Raphael-Boichot/Mitsubishi-M64282FP-dashcam/SD/README.md

# These files have to be copied at the root of SD card.

## Powershell scripts made by [HerrZatacke](https://github.com/HerrZatacke)

- **Upscaler_Camera.ps1** converts 1x BMP files from /Camera folder to 8x PNG;
- **Upscaler_Slitscan.ps1** converts 1x BMP files from /Slitscan folder to 8x PNG;
- **Upscaler_MS.ps1** converts raw datafiles files from /MS (Motion Sensor) folder to 8x PNG; 
- **Upscaler_TL.ps1** converts raw datafiles files from /TL (Time Lapse) folder to 8x PNG;

I you want to directly store Motion Sensor and Timelapse images in BMP (for example because you have no access to Powershell on your OS, set timelapserawrecordingMode to 0 in json config file (see next section). Recording in BMP format decreases a bit the available recording fps (it goes down to about 3 at most instead of 4).

## Matlab and GNU Octave conversion scripts

The projet comes with image conversion codes both compatible with Matlab if you are rich enough or [GNU Octave](https://octave.org/). Sadly, movie maker is only Matlab compatible but animated gifs are cool enough anyway. If you like Python, do not hesitate to PR codes, I would be glad to add them.

The script to make RGB animations contains all the necessary inputs to balance each color individually. The DashBoy Camera itself just does its best to expose as optimally as it can with each filter (thus collecting the maximum possible information). It's up to the user (you) to calibrate the white balance manually.

## json configuration file

**config.json** is the general configuration file for the DashBoy Camera. It has always priority on internal default configuration. Config.json is not a mandatory file but it pimps available options.

User can keep the current default values without modifying anything. Advanced user are advised to look into code what is the effect of each parameter. **Value can be changed but not the length of tables. Values MUST be entered as decimal.** Here is the signification of each variable in detail:

- **timelapserawrecordingMode:** 1 = recording to .raw file, 0 = recording to 1x bmp files with a limit of 1024 files per folder (it od course increases the folder # automatically in case of folder capacity overflow);
- **timelapseDelay:** list of actions associated with the timelapse button. Any positive value is a delay for timelapse in ms (even zero), -1 is the regular camera mode, -2 is the motion sensor mode, -3 is slit-scan infinite mode and -4 is slit-scan x128 mode. The list **must began by -2 then -1**, other values/oreder are not critical;
- **prettyborderMode:** >1 = pretty borders, 0 = image without border. Quick reboot during "NOW BOOTING... message to roll over the borders;
- **nightMode:** 1 = allows to go decrease the sensor clock to over expose image at night, 0 = constant sensor clock;
- **motiondetectionThreshold:** value for the motion detection threshold. 0 = detect everything, 1 = detect nothing. 0.025 is a good starting value, the lower, the lore sensitive to motion;
- **enforce2DEnhancement:** 1 = 2D enhancement always activated, 0 = set by registers - Valid only with dithering off;
- **cancel2DEnhancement:** 1 = 2D enhancement always deactivated, 0 = set by registers - Valid only with dithering off;
- **hdrExposures:** list of 8 exposures in HDR mode, in multiplier of the last best known exposure. It is recommended to stay within -1EV to +1EV. Taking 8 times the value 1 creates a multi-exposures shot;
- **ditherMatrix:** dithering matrix used in single register strategy, derived from a 4x4 bayer matrix. Create your own by going to [this fancy site](https://herrzatacke.github.io/dither-pattern-gen/);
- **gameboycameraMode:** 0 = single register strategy, 1 = Game Boy Camera strategy with variable registers;
- **lowvoltageThreshold:** voltage threshold for black level in non dithered Game Boy Camera strategy (0=0.0 Volts, 255 = 3.3 volts);
- **highvoltageThreshold:** voltage threshold for white level in non dithered Game Boy Camera strategy (0=0.0 Volts, 255 = 3.3 volts);
- **lowditherMatrix:** dithering matrix used in Game Boy Camera strategy - low ligth or high exposure times, derived from a 4x4 bayer matrix; 
- **highditherMatrix:** dithering matrix used in Game Boy Camera strategy - high ligth or low exposure times, derived from a 4x4 bayer matrix;
- **fixedExposure:** 0 = auto-exposure, 1 = fixed exposure, for astrophotography for example;
- **fixedDelay:** max is 65535 (about 1 second), min is 48 (about 0.768 ms);
- **fixedDivider:** clock divider, the more, the longer the exposure. For example 2 double the exposure time;
- **lookupTableRGB565:** Colorscale for display, may increase comfort and contrast, go to [this other fancy site](https://herrzatacke.github.io/gradient-values/) to generate your own (just copy paste table of values to the json);
- **exposurexWindow:** exposure box width in pixels, centered (max is 128, whole image);
- **exposureyWindow:** exposure box heigth in pixels, centered (max is 120, whole image);
- **focusPeaking:** 0 = normal mode, 1 = [focus peaking](https://en.wikipedia.org/wiki/Focus_peaking) activated;
- **focuspeakingThreshold:** threshold for focus peaking. The lower the value, the more pixels indicates good focusing (values 0..255).
- **M64283FPsensor:** 0 = normal mode, 1 = special strategy to handle the unobtainium M64283FP sensor. It is advised to deactivate gameboycameraMode when using this mode to swicth to a single register strategy.
- **slitscanDelay:** delay between slits in ms in slit-scan mode. 0 allows recording about 12 slits per seconds in full sun. 2000 gives interesting images with clouds. Be creative !
- **colorMode:** 0 = normal mode, 1 = gives help to create color animation in timelapse mode: faster autoexposure and color filter to use indicated. A PWM signal is also output on GPIO22 (see next variable). Using the servo output is not mandatory, you can pass filters by hand.
- **colorservoPositions:** triplet for RGB positions of the servo arm in degree. PWM is on GPIO22. To power the servo, use a [wire connected to any 5V line](/Docs%20and%20research/Image%20files/PCB_bare_version_2.0_servo_wiring.png) (possible) or an external power source (better).
- **jsonCorruption:** do not modify, internal check for json integrity. If this value is not reported correctly, json is considered as corrupted, copy a fresh one to SD card.

## Convert images to movie, script made by [HerrZatacke](https://github.com/HerrZatacke)

Just install ffmpeg from Powershell ran as administrator following this method: **[Method 2: Install FFmpeg via Chocolatey](https://adamtheautomator.com/install-ffmpeg/)**.
Then run the following command into you image folder (png or bmp, adapt it):
    
    ffmpeg -i %07d.png -s 1024x896 -sws_flags neighbor -r 30 -vcodec libx264 -c:v libx264 -crf 30 -pix_fmt yuv420p output.mp4
    
Or use the Matlab codes provided (GNU Octave version is not able to generate video files, only animated gifs).
