Raphael-Boichot/Mitsubishi-M64282FP-dashcam/PCB/128x160_PCB and schematic/README.md

To be edited with the Standard version of EasyEDA. These PCB versions have been validated in real.
Be carefull with the JST/ZH 9 pin socket, it must be **a vertical SMD socket** or there is a risk of polarity inversion
