Raphael-Boichot/Mitsubishi-M64282FP-dashcam/Docs and research/Image files/Project schematics.pptx

LOCK

HDR

Dither

TL/C

REBOOT

Record

SD_MISO

SD_CS

SD_MOSI

FREE

+3.3V

CAM_VOUT

CAM_GND

CAM_VCC

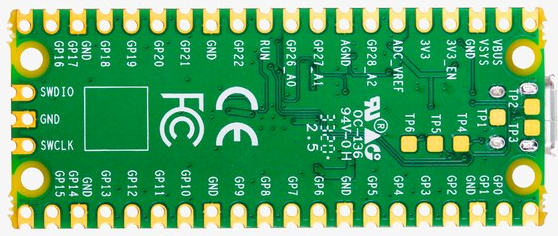
[picture p24: figure]

SD_SCK

FREE

CAM_READ

CAM_CLOCK

Access to SD card

Exposure time

CAM_RESET

CAM_SIN

CAM_START

CAM_LOAD

READ

RESET

SDA

SCK

FREE

SIN

LOAD

RESET

CLOCK

A0

CS

FREE

FREE

FREE

FREE

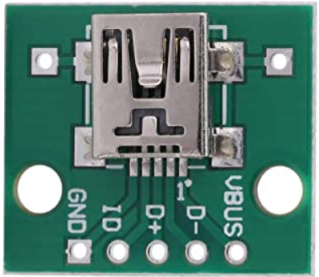
[picture p25: figure]

START

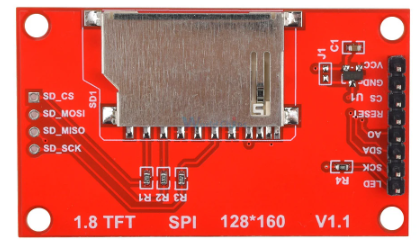
[picture p26: figure]

+5V

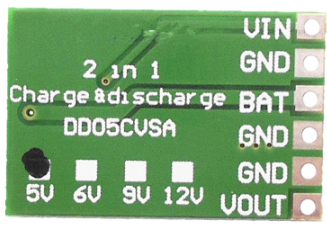
[picture p27: figure]

Display ON/OFF

Main ON/OFF

Batt+

Batt-

## Slide 2

LOCK

HDR

Dither

REBOOT

Record

SD_MISO

SD_CS

SD_MOSI

FREE

+3.3V

CAM_VOUT

CAM_GND

CAM_VCC

SD_SCK

FREE

FREE

CAM_READ

CAM_CLOCK

Access to SD card

Exposure time

CAM_RESET

CAM_SIN

CAM_START

CAM_LOAD

READ

RESET

SDA

SCK

TL/C

SIN

LOAD

RESET

CLOCK

A0

CS

FREE

FREE

FREE

FREE

START

+5V

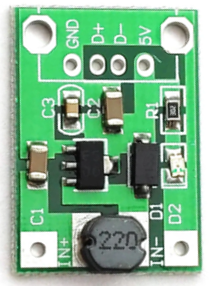
[picture p28: figure]

Display ON/OFF

Batt+

Batt-

Main

2xAA NiMH
