Raphael-Boichot/Mitsubishi-M64282FP-dashcam/Docs and research/Image files/Slit_scans.pptx

Slit-scan mode infinite

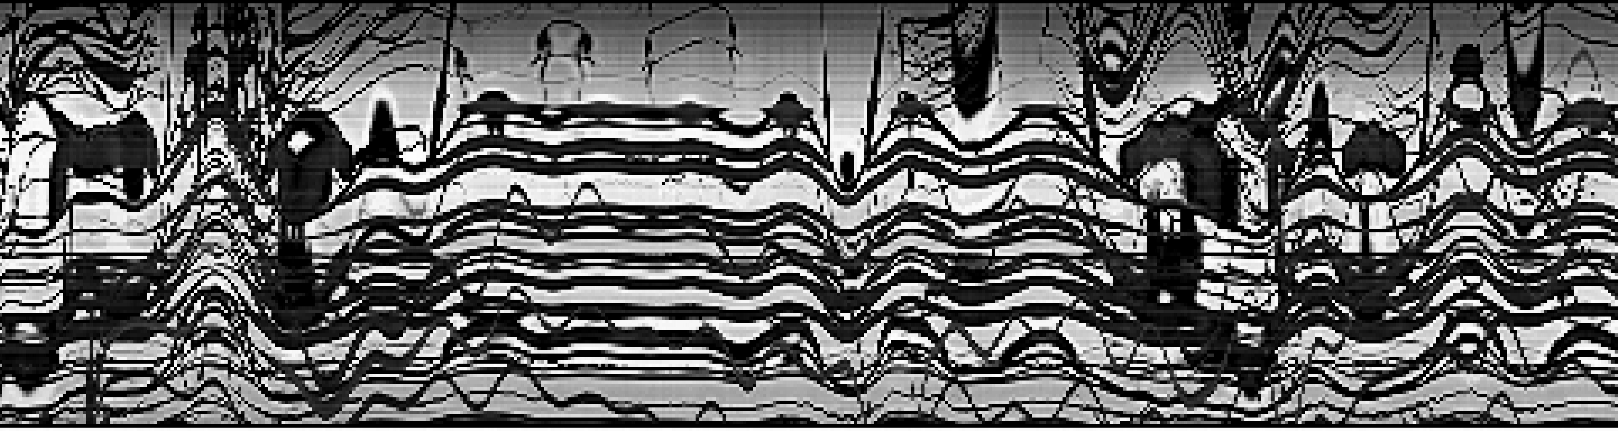
[picture p29: figure]

Slit-scan mode x128

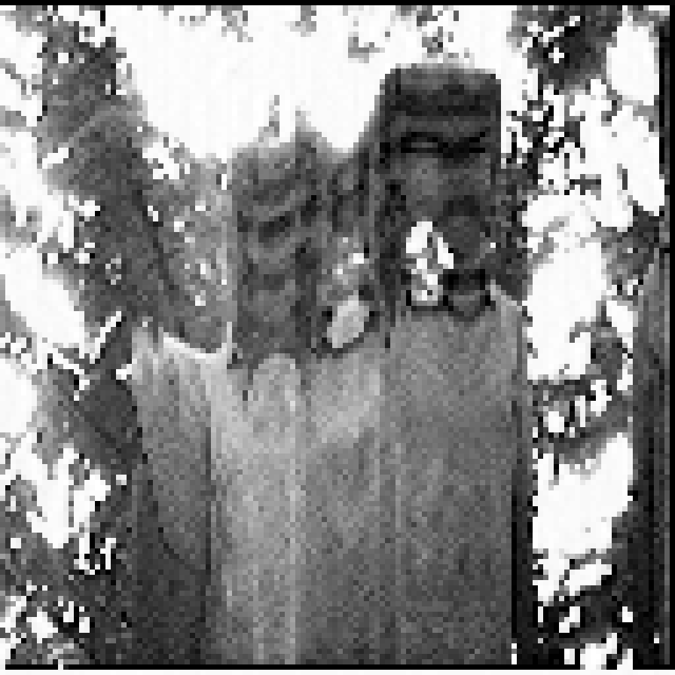
[picture p30: figure]
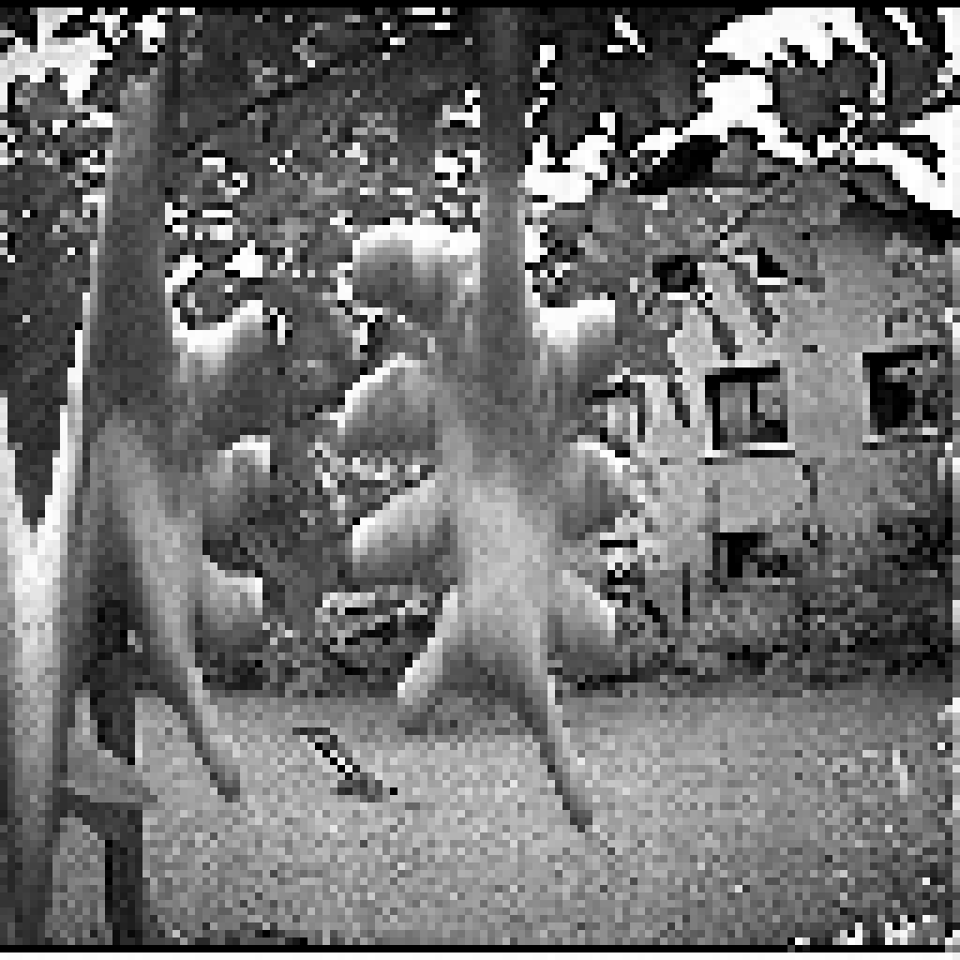
[picture p31: figure]
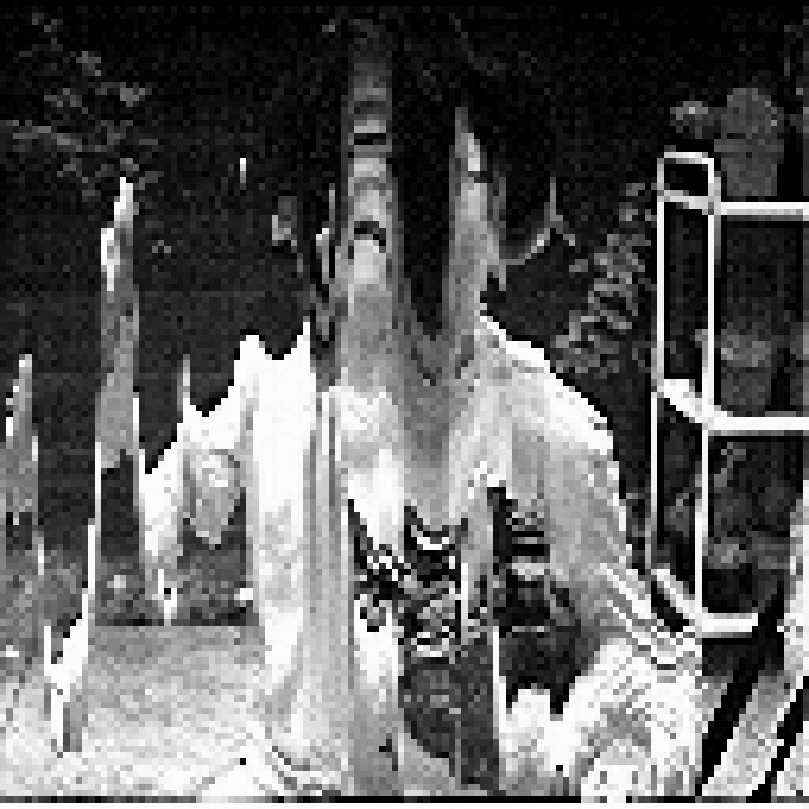
[picture p32: figure]
