Raphael-Boichot/Mitsubishi-M64282FP-dashcam/Docs and research/Bibliography/Joypad 73 Mars 1998 page031 (French).jpg

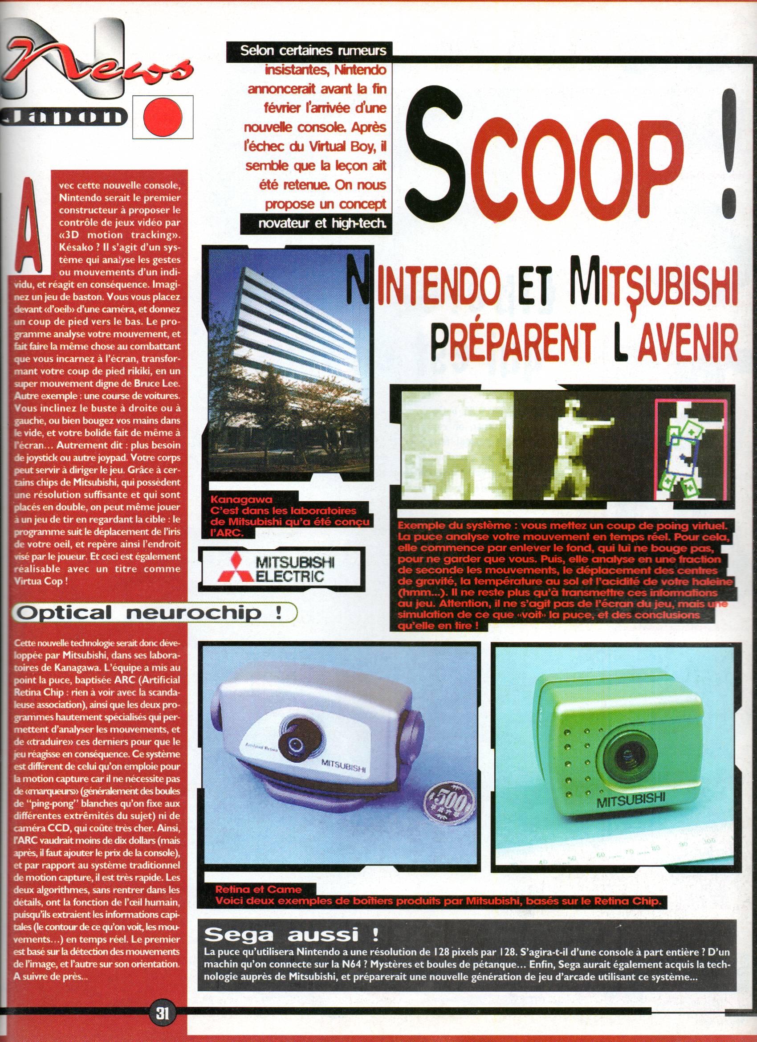
Docs and research/Bibliography/Joypad 73 Mars 1998 page031 (French).jpg
