Raphael-Boichot/Mitsubishi-M64282FP-dashcam/Docs and research/Bibliography/RGB sensor.png

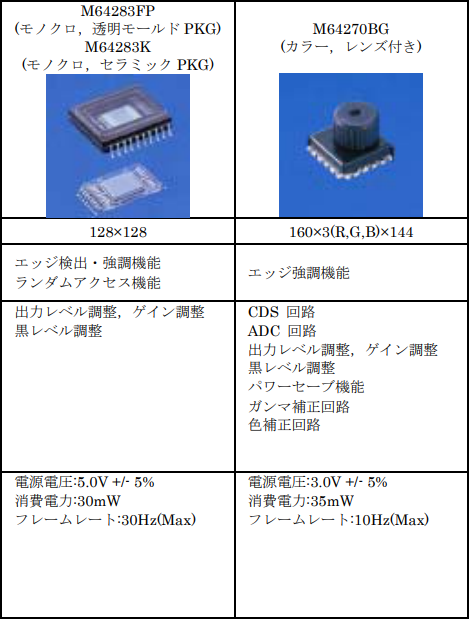
Docs and research/Bibliography/RGB sensor.png
