Raphael-Boichot/Mitsubishi-M64282FP-dashcam/Docs and research/Image files/9 pins JST connector.png

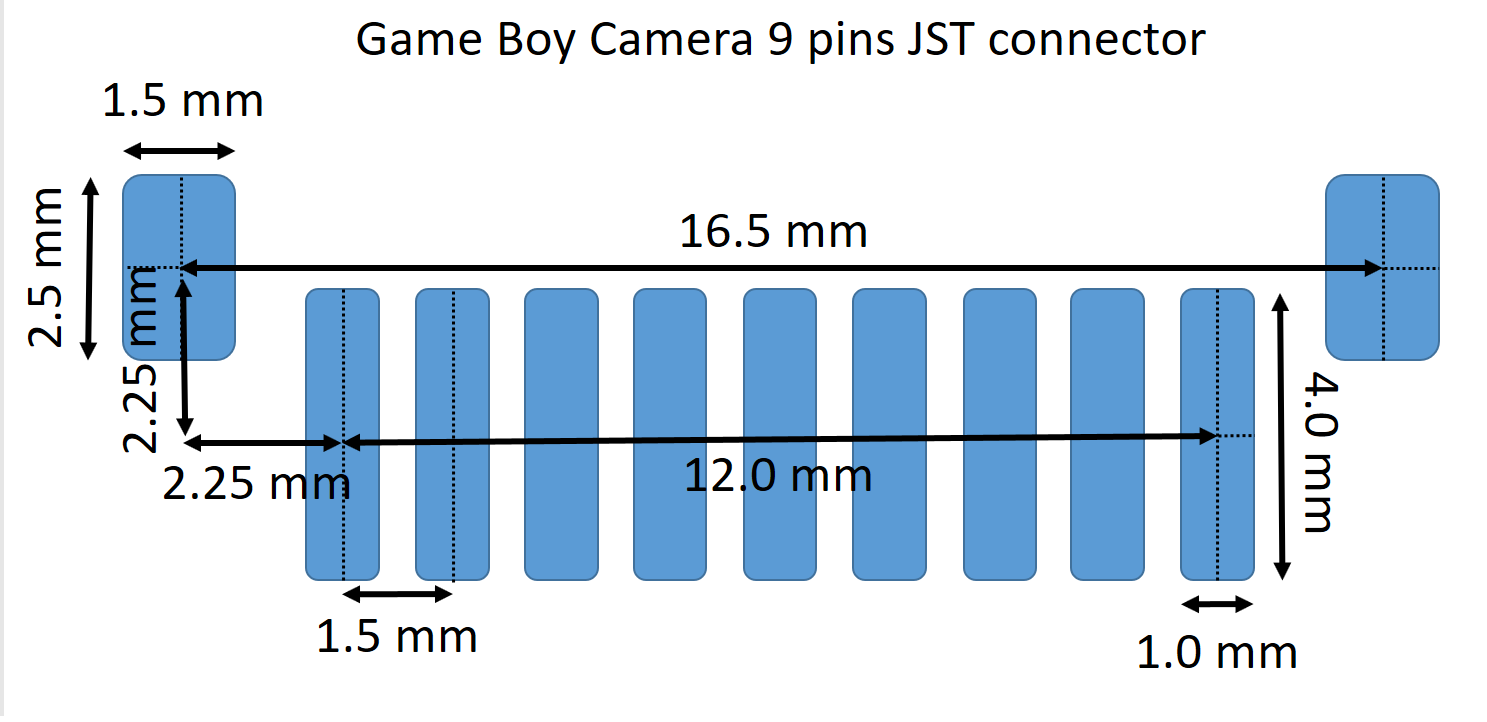
Docs and research/Image files/9 pins JST connector.png
