Raphael-Boichot/Mitsubishi-M64282FP-dashcam/Docs and research/Image files/Backside.png

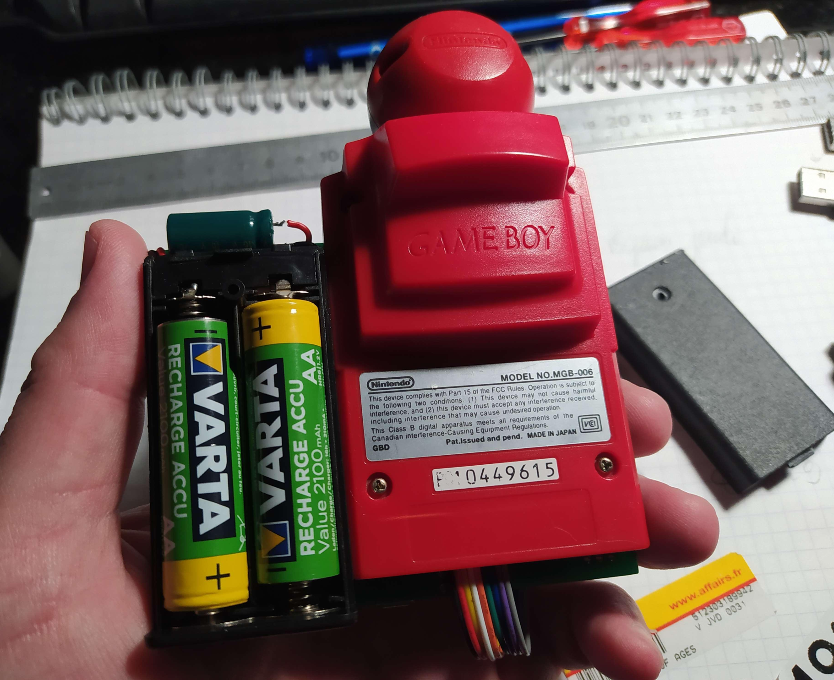
Docs and research/Image files/Backside.png
