Raphael-Boichot/Mitsubishi-M64282FP-dashcam/Docs and research/Image files/Colorwheel back.jpg

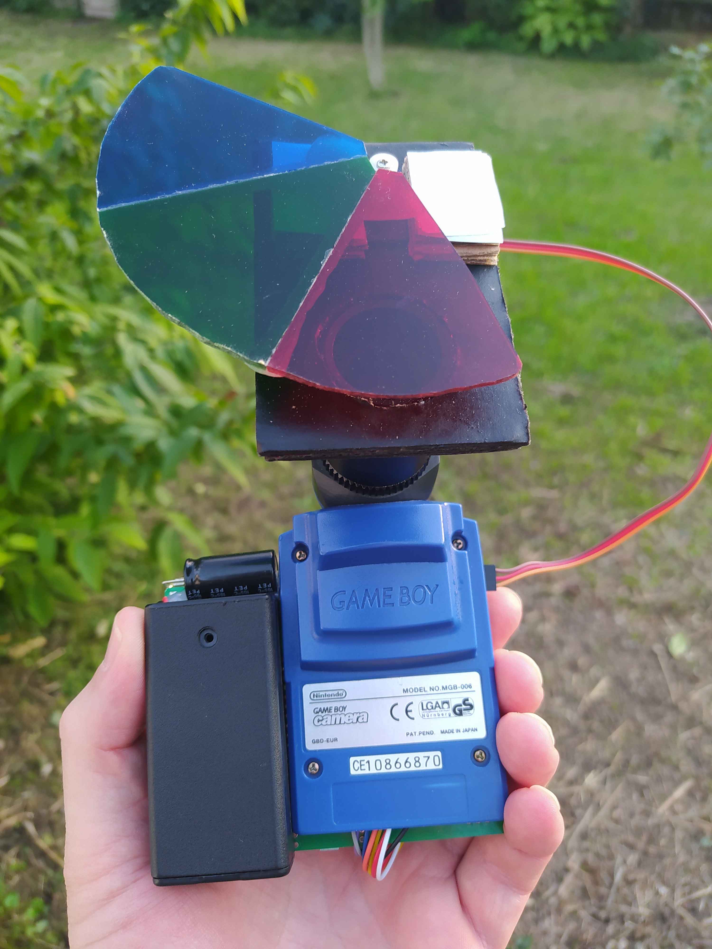
Docs and research/Image files/Colorwheel back.jpg
