Raphael-Boichot/Mitsubishi-M64282FP-dashcam/Docs and research/Image files/Colorwheel front.jpg

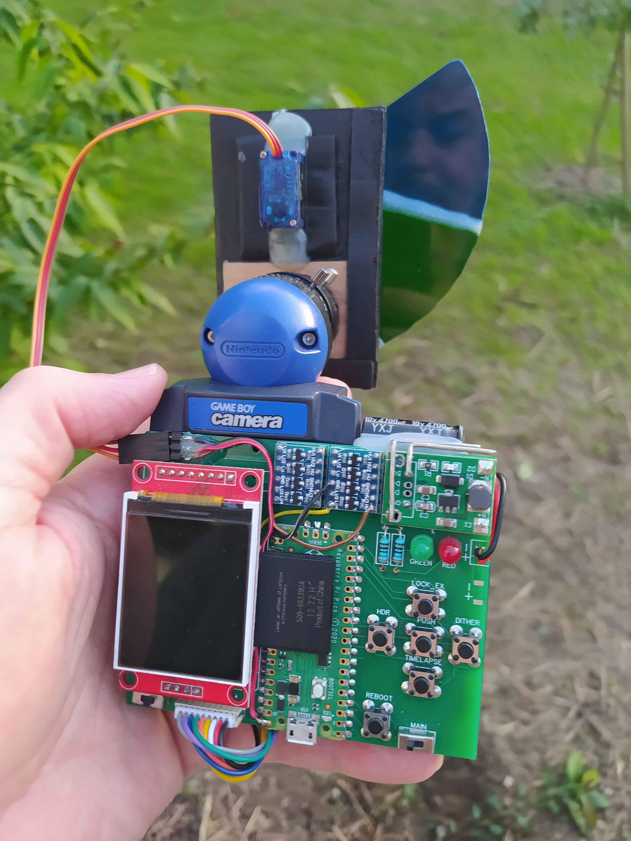
Docs and research/Image files/Colorwheel front.jpg
