Raphael-Boichot/Mitsubishi-M64282FP-dashcam/Docs and research/Image files/Comparison.png

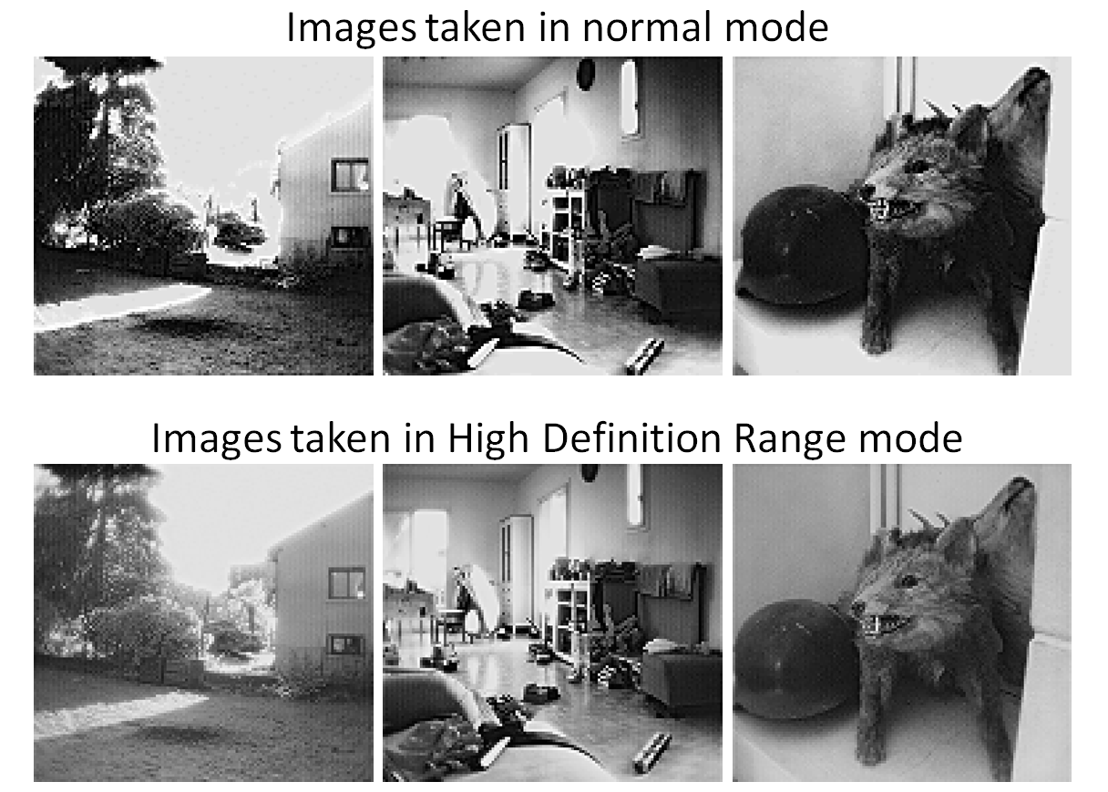
Docs and research/Image files/Comparison.png
