Raphael-Boichot/Mitsubishi-M64282FP-dashcam/Docs and research/Image files/Concept_board_February_2023.jpg

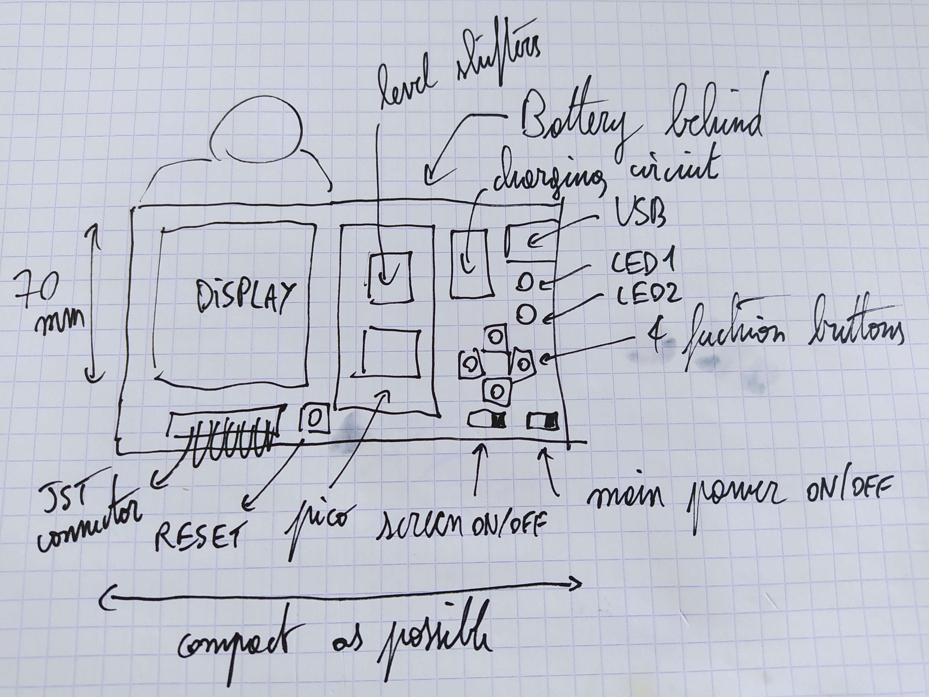
Docs and research/Image files/Concept_board_February_2023.jpg
