Raphael-Boichot/Mitsubishi-M64282FP-dashcam/Docs and research/Image files/Fatal_error.jpg

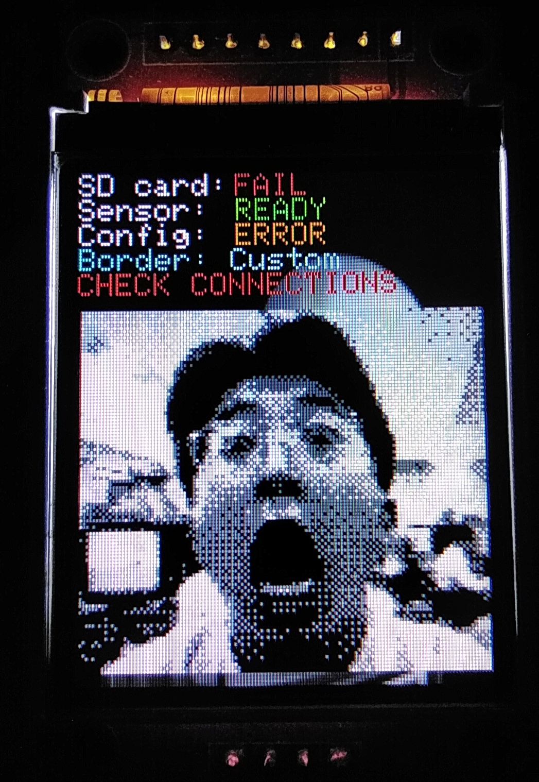
Docs and research/Image files/Fatal_error.jpg
