Raphael-Boichot/Mitsubishi-M64282FP-dashcam/Docs and research/Image files/Image of a M64282FP taken with a M64283FP.png

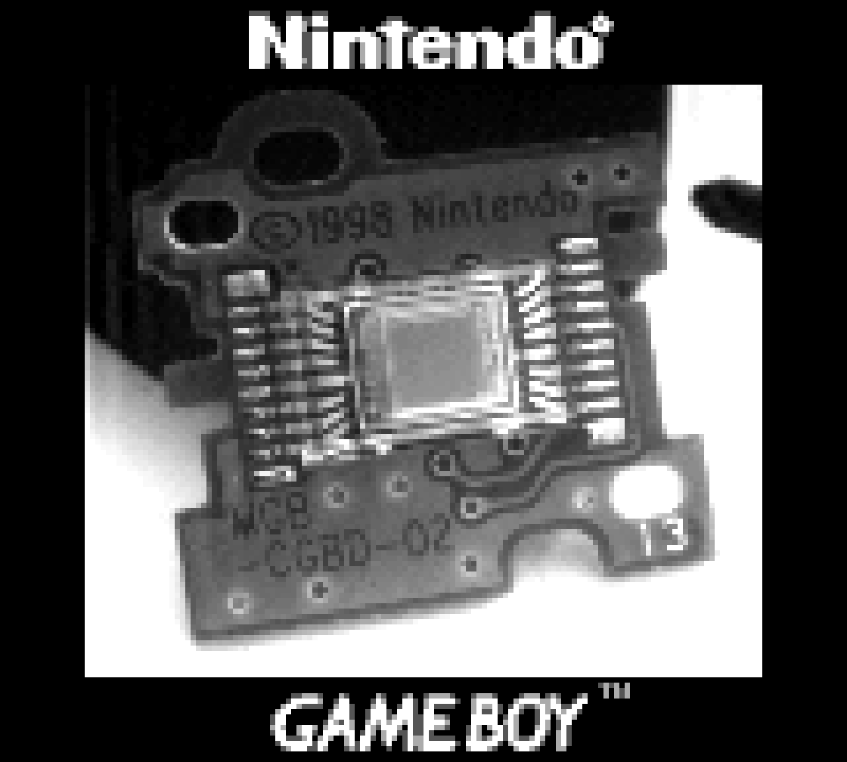
Docs and research/Image files/Image of a M64282FP taken with a M64283FP.png
