Raphael-Boichot/Mitsubishi-M64282FP-dashcam/Docs and research/Image files/PCB_bare_version_2.0.png

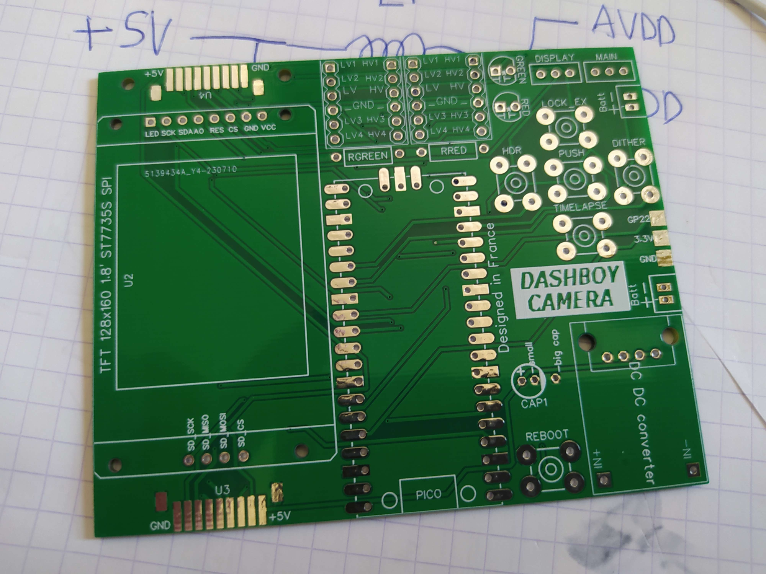
Docs and research/Image files/PCB_bare_version_2.0.png
