Raphael-Boichot/Mitsubishi-M64282FP-dashcam/Docs and research/Image files/Prototype.png

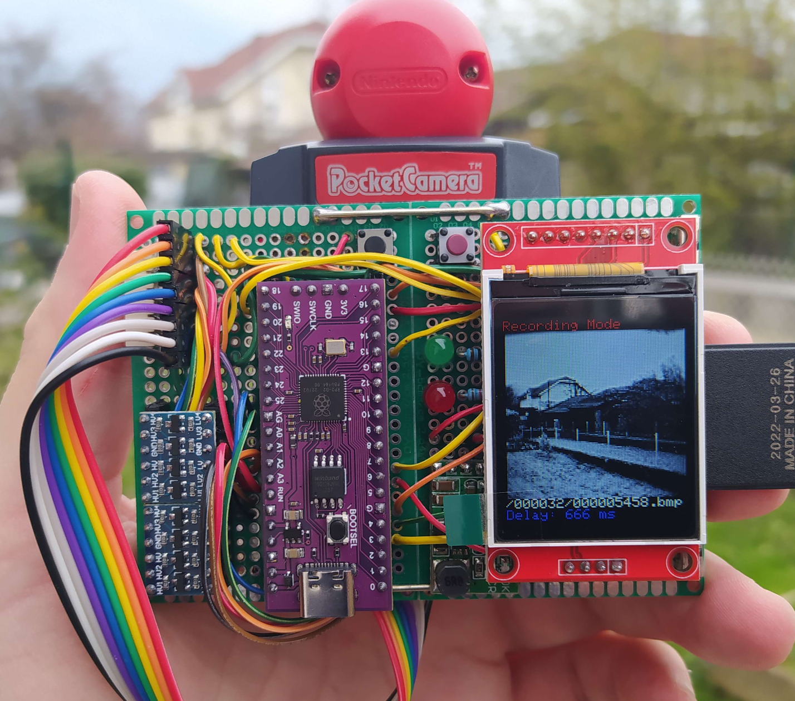
Docs and research/Image files/Prototype.png
