Raphael-Boichot/Mitsubishi-M64282FP-dashcam/Docs and research/Image files/Prototype_ESP32_2022.jpg

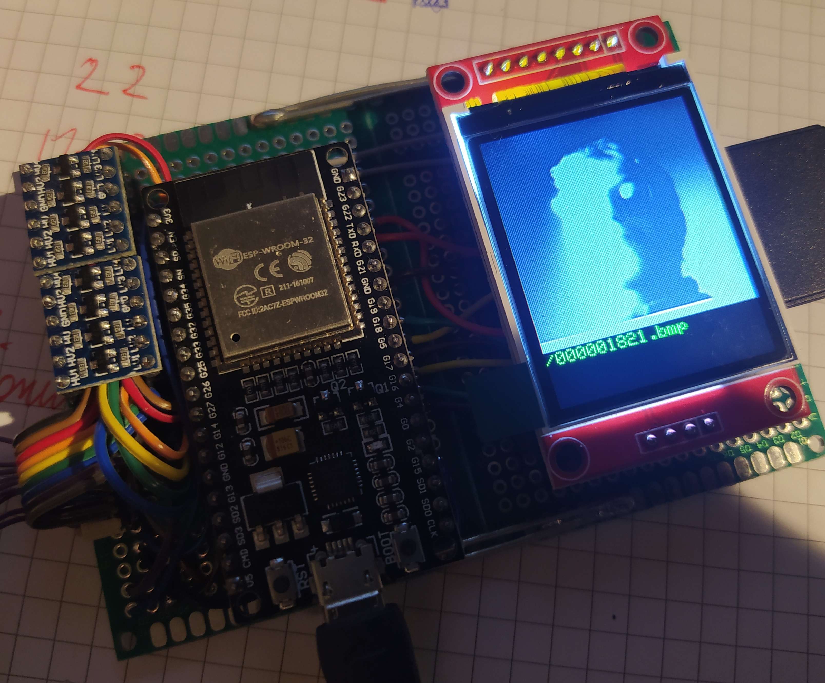
Docs and research/Image files/Prototype_ESP32_2022.jpg
