Raphael-Boichot/Mitsubishi-M64282FP-dashcam/Docs and research/Image files/RGB_example_3.gif

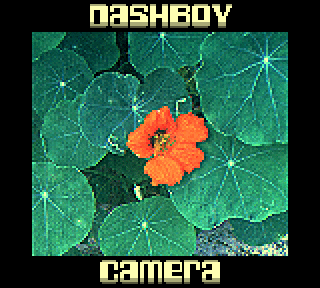
Docs and research/Image files/RGB_example_3.gif
