Raphael-Boichot/Mitsubishi-M64282FP-dashcam/Docs and research/Image files/RGB_example_5.gif

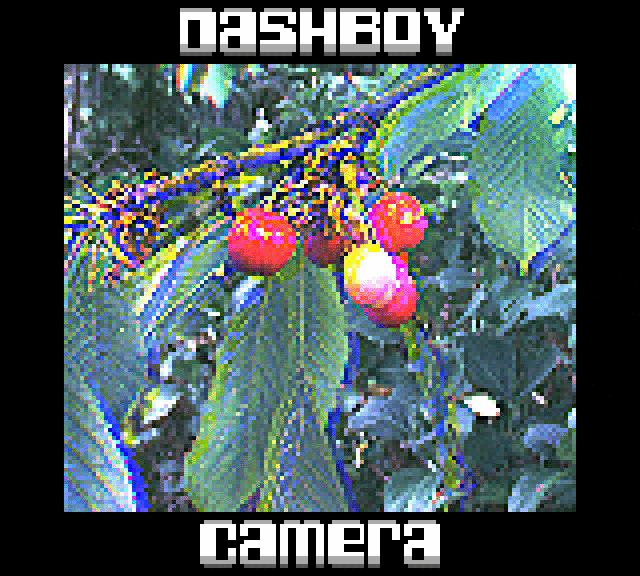
Docs and research/Image files/RGB_example_5.gif
