Raphael-Boichot/Mitsubishi-M64282FP-dashcam/Docs and research/Image files/Sensor_comparison_2.JPG

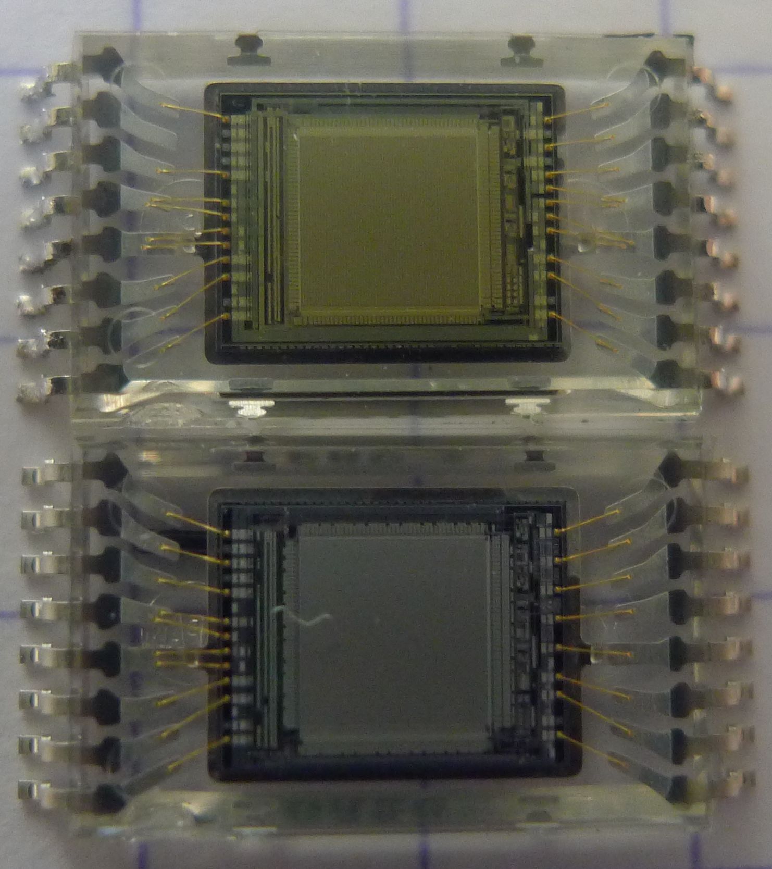
Docs and research/Image files/Sensor_comparison_2.JPG
