Raphael-Boichot/Mitsubishi-M64282FP-dashcam/Docs and research/Image files/Sensor_pinout.png

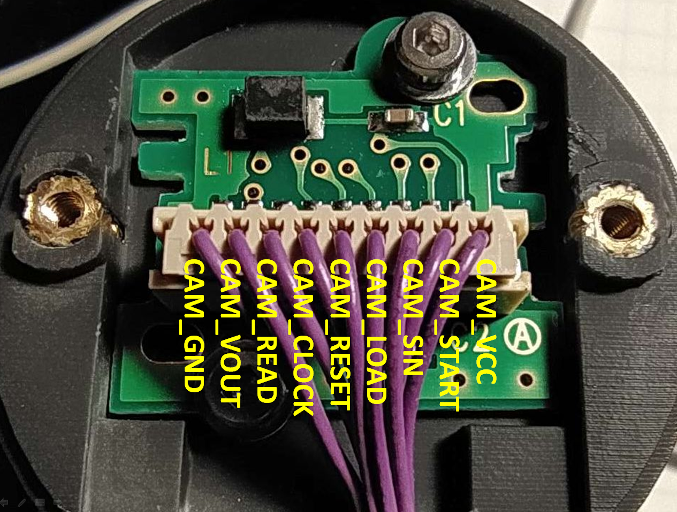
Docs and research/Image files/Sensor_pinout.png
