Raphael-Boichot/Mitsubishi-M64282FP-dashcam/Docs and research/Image files/Support_for_ST7789_driver.png

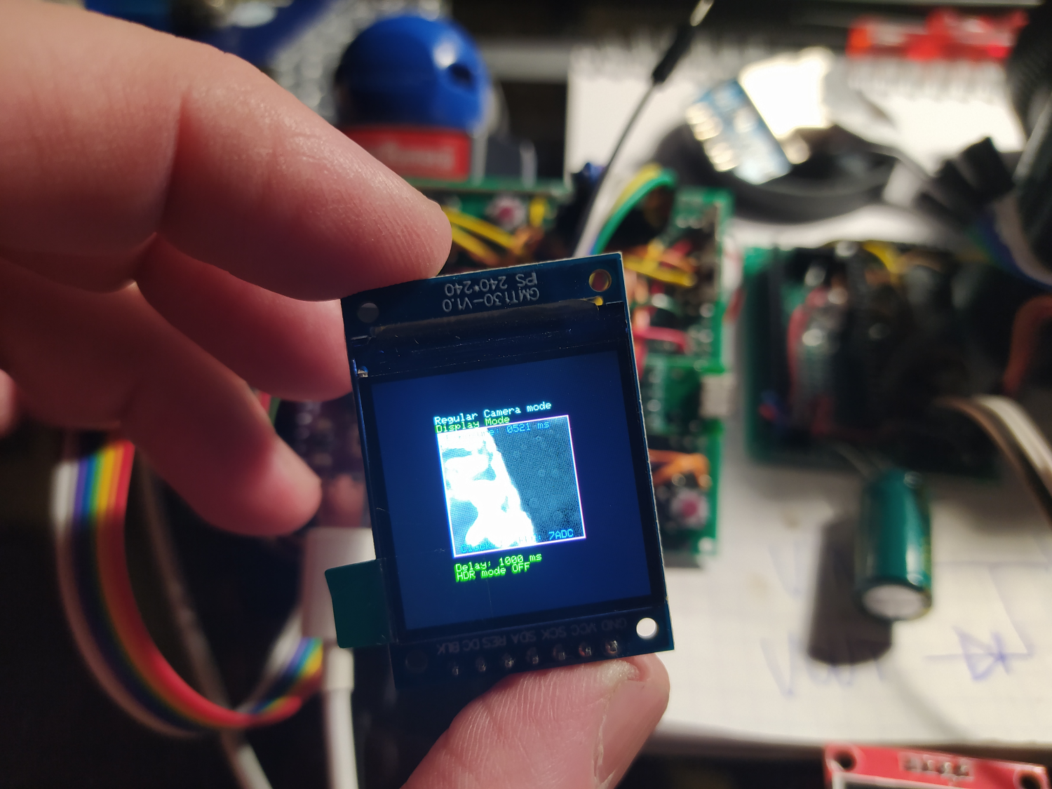
Docs and research/Image files/Support_for_ST7789_driver.png
