Raphael-Boichot/Mitsubishi-M64282FP-dashcam/PCB/128x160_PCB and schematic/Main PCB/Main_PCB.png

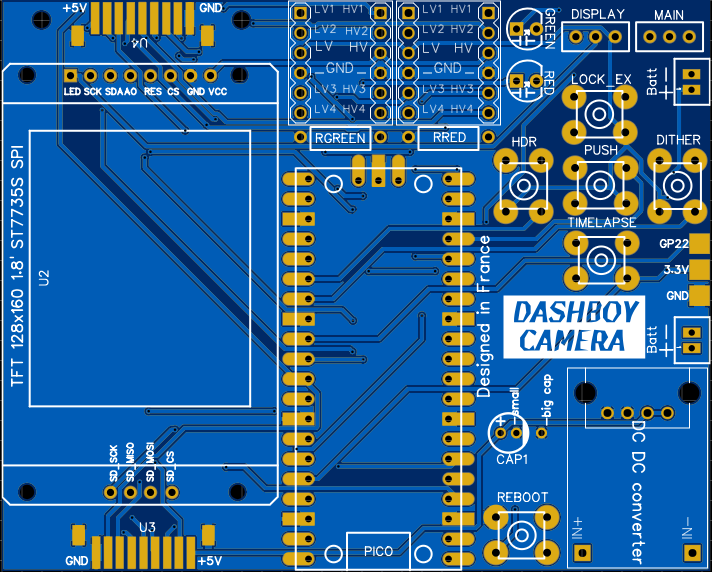
PCB/128x160_PCB and schematic/Main PCB/Main_PCB.png
