Raphael-Boichot/Mitsubishi-M64282FP-dashcam/PCB/128x160_PCB and schematic/Sensor to PCB adapter board/Tiny adapter board.png

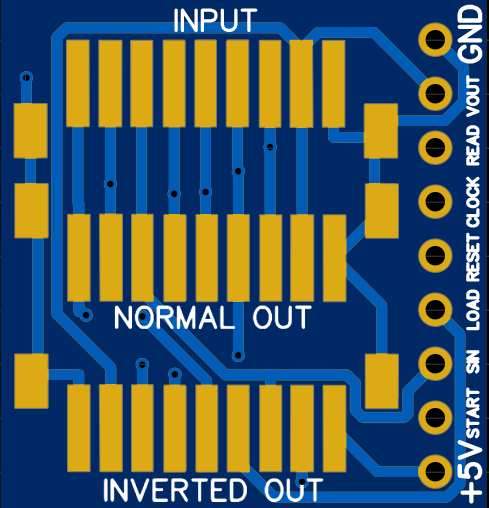
PCB/128x160_PCB and schematic/Sensor to PCB adapter board/Tiny adapter board.png
