Raphael-Boichot/Mitsubishi-M64282FP-dashcam/Tools/Border_1.png

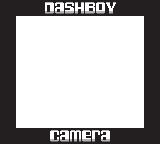
Tools/Border_1.png
