Raphael-Boichot/Mitsubishi-M64282FP-dashcam/Tools/Border_3.png

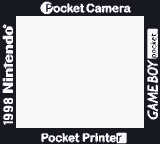
Tools/Border_3.png
