Raphael-Boichot/Mitsubishi-M64282FP-dashcam/Tools/Border_4.png

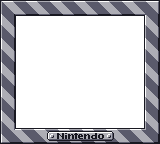
Tools/Border_4.png
