Raphael-Boichot/Mitsubishi-M64282FP-dashcam/Tools/Border_5.png

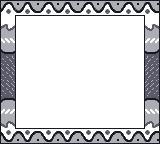
Tools/Border_5.png
