Raphael-Boichot/Mitsubishi-M64282FP-dashcam/Docs and research/Image files/User_manual.pptx

What the DashBoy does
/general informations

Access to SD
/error
/acknowledge

Mode chosen

Green when sensor is being exposed

Display switch
(saves battery during timelapses)

Main ON/OFF switch

Actual exposure time

DISPLAY

MAIN

How far from perfect exposure

Actual exposure area

Regular camera mode
Display mode

Exposure: 1039 ms
Error : +67

A7 0A FF FF 01 00 01 03
Clock/1 REG:FFFF

/Camera/0000001.bmp
No delay 82FP
HDR mode OFF 5L

LOCK_EXP

Locks exposure
(border becomes green)

Activates dithering

HDR

PUSH

DITHER

TIMELAPSE

Take a picture !

Activates HDR mode ± 1EV
(requires a tripod)

Cycles between:
- Regular camera mode
- Burst mode
- Timelapse 1 s delay
- Timelapse 30 s delay
- Timelapse 60 s delay
- Slit scan mode infinite
- Slit scan mode 128 pixels
- Motion sensor mode

Cycle fast to change between borders (7 possible + no border)

Current camera registers

Current exposure registers

Type of sensor

Sensor clock divider if night mode

REBOOT

Current file recorded

Delay to the next image if any

HDR mode
active or not

Exposure strategy (see code)
