Raphael-Boichot/Mitsubishi-M64282FP-dashcam/Docs and research/Image files/DebagameTesterSI-Pictures.png

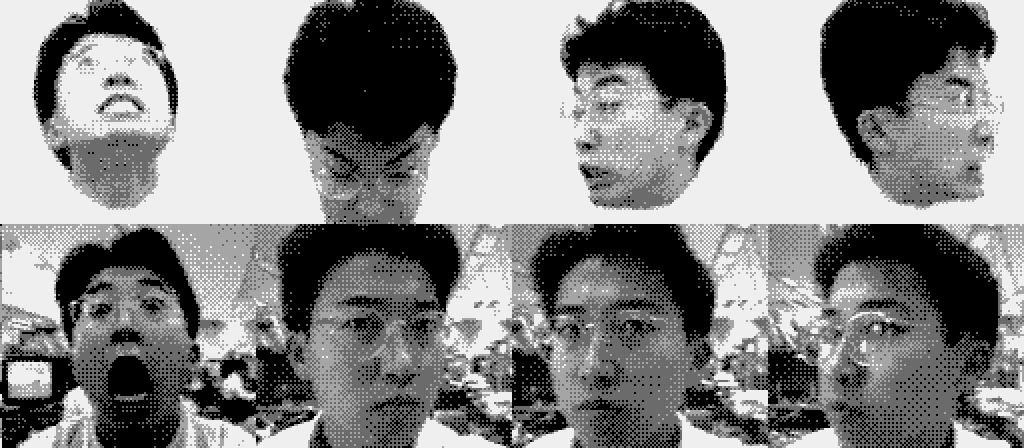
Docs and research/Image files/DebagameTesterSI-Pictures.png
