Raphael-Boichot/Mitsubishi-M64282FP-dashcam/PCB/128x160_PCB and schematic/Main PCB/Schematic_Dashboy camera_NiMH_2023-05-14.pdf

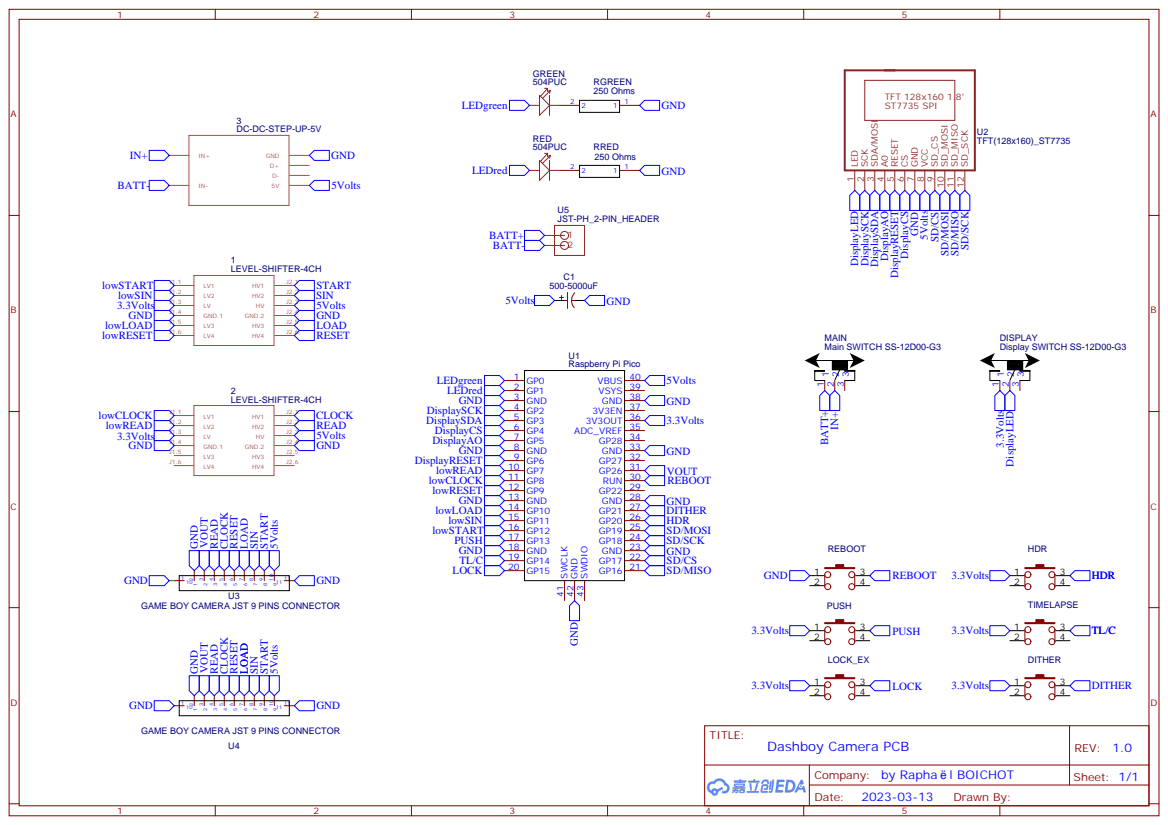
[picture p65: page 1]

DC-DC-STEP-UP-5V

GAME BOY CAMERA JST 9 PINS CONNECTOR

Company: by Rapha l BOICHOT
