Raphael-Boichot/Mitsubishi-M64282FP-dashcam/(list of files, drawings)

Other design files:
PCB/128x160_PCB and schematic/Main PCB/PCB_PCB_Dashboy camera_NiMH_2_2023-05-14.json
PCB/128x160_PCB and schematic/Main PCB/SCH_Dashboy camera_NiMH_2023-05-14.json
PCB/128x160_PCB and schematic/Sensor to PCB adapter board/PCB_Tiny-board_2024-03-03.json
PCB/128x160_PCB and schematic/Sensor to PCB adapter board/SCH_PCB_Dashboy_subboard_2023-03-29.json
