Raphael-Boichot/Mitsubishi-M64282FP-dashcam/Codes/128x160_Dashboy_Camera/prettyborder.h

const unsigned char max_border = 7;
//borders are encoded with a cheap RLE algorithm {number of pixels, color, number of pixels, colors, etc}, 160x144 pixels
//custom border made by Mgkastra
const unsigned char prettyborder_1[] = { 0xFF, 0x00, 0x6E, 0x00, 0x08, 0x02, 0x03, 0x00, 0x07, 0x02, 0x03, 0x00, 0x07, 0x02, 0x02, 0x00, 0x03, 0x02, 0x03, 0x00, 0x03, 0x02, 0x01, 0x00, 0x09, 0x02, 0x03, 0x00, 0x07, 0x02, 0x02, 0x00,
                                         0x04, 0x02, 0x03, 0x00, 0x03, 0x02, 0x59, 0x00, 0x09, 0x03, 0x01, 0x00, 0x09, 0x03, 0x01, 0x00, 0x09, 0x03, 0x01, 0x00, 0x03, 0x03, 0x03, 0x00, 0x03, 0x03, 0x01, 0x00, 0x0A, 0x03, 0x01, 0x00,
                                         0x09, 0x03, 0x01, 0x00, 0x04, 0x03, 0x03, 0x00, 0x03, 0x03, 0x59, 0x00, 0x09, 0x03, 0x01, 0x00, 0x02, 0x03, 0x03, 0x00, 0x04, 0x03, 0x01, 0x00, 0x02, 0x03, 0x05, 0x00, 0x02, 0x03, 0x01, 0x00,
                                         0x03, 0x03, 0x03, 0x00, 0x03, 0x03, 0x01, 0x00, 0x04, 0x03, 0x04, 0x00, 0x02, 0x03, 0x01, 0x00, 0x03, 0x03, 0x03, 0x00, 0x03, 0x03, 0x02, 0x00, 0x03, 0x03, 0x03, 0x00, 0x02, 0x03, 0x5A, 0x00,
                                         0x02, 0x03, 0x03, 0x00, 0x04, 0x03, 0x01, 0x00, 0x02, 0x03, 0x03, 0x00, 0x04, 0x03, 0x01, 0x00, 0x02, 0x03, 0x05, 0x00, 0x02, 0x03, 0x01, 0x00, 0x03, 0x03, 0x03, 0x00, 0x03, 0x03, 0x01, 0x00,
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
                                         0x05, 0x00, 0x04, 0x02, 0x56, 0x00, 0x02, 0x02, 0x02, 0x00, 0x03, 0x02, 0x02, 0x00, 0x02, 0x02, 0x01, 0x00, 0x09, 0x02, 0x07, 0x00, 0x03, 0x02, 0x01, 0x00, 0x09, 0x02, 0x01, 0x00, 0x09, 0x02,
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
