Raphael-Boichot/Mitsubishi-M64282FP-dashcam/(commit log)

2023-02-08 A version to record directly from a Game Boy Camera
2023-02-08 Version to directly probe a Game Boy Camera
2023-02-12 Correct a HUGE error on dithering algorithm
    [config.h]
2023-02-13 Tool to make onboard fancy boarders
2023-02-13 New option for border
    [config.txt]
2023-02-14 Locked exposure to 0x0030 to avoid artifacts
    [config.h, prettyborder.h]
2023-02-18 added timelapse or regular camera as option
2023-02-19 Change one pin affectation
2023-02-28 Minor change in conditions to avoid exposure bug
    [config.h, prettyborder.h, splash.h]
2023-03-07 bugfix in directory name
    [config.h]
2023-03-10 Reversing to single core
    [config.h]
2023-03-12 Add a locking exposure button
2023-03-12 Locking exposure button added
2023-03-13 EasyDA PCB
    [PCB_PCB_Dashboy camera_2023-03-13.json, SCH_Dashboy camera_2023-03-13.json]
2023-03-15 V2 in preparation
    [PCB_PCB_Dashboy camera_NiMH_2023-03-14.json, SCH_Dashboy camera_NiMH_2023-03-14.json]
2023-03-21 added pinout sensor side
2023-04-06 Game Boy camera mode
2023-04-08 New type of connector added
2023-04-08 Reordering the folders
    [PCB_PCB_Dashboy camera_NiMH_2023-03-29.json, PCB_PCB_PCB_Dashboy camera_NiMH_2023-03-29_2023-03-30.json, PCB_Tiny board_2023-03-29.json, SCH_Dashboy camera_NiMH_2023-03-29.json, SCH_PCB_Dashboy_subboard_2023-03-29.json]
2023-04-08 Game Boy Camera strategy 90% completed
2023-04-08 Game Boy Camera strategy 99% complete
2023-04-16 Game Boy Camera strategy ready
2023-04-16 Calibration improved
2023-04-16 New calibration
2023-04-16 voltage thresholds added
2023-04-16 Voltage thresholds from json
2023-04-27 Motion sensor mode
2023-04-28 Motion sensor counter added
2023-05-06 Quick reboot during "NOW BOOTING..." rolls over borders
    [128x160_Dashboy_Camera.ino]
2023-05-11 Fix minor border issue
    [prettyborder.h]
2023-05-13 New saving battery strategy + enforce 2D enhancement
2023-05-14 PCB V2 with ground plane
    [PCB_PCB_Dashboy camera_NiMH_2_2023-05-14.json, SCH_Dashboy camera_NiMH_2023-05-14.json]
2023-05-28 Added a crash screen
    [128x160_Dashboy_Camera.ino, splash.h]
2023-06-29 Made a clean BMP header generator + bugfix
    [128x160_Dashboy_Camera.ino]
2023-07-04 ADC channel choice bugfix
    [128x160_Dashboy_Camera.ino]
2023-07-04 ADC channel init bugfix
2023-07-08 Improved calibration
2023-07-10 Bugfix in single register mode
    [128x160_Dashboy_Camera.ino, config.h]
2023-07-10 Anti-jitter system working
2023-07-10 Anti-jittering system working
2023-08-01 Adding support for the M64283FP sensor
2023-08-02 Support for M64283FP sensor
2023-08-06 Support for the M64283FP sensor + code refactoring
2023-08-18 Anti-glare strategy for M64283FP sensor
2023-08-19 Some display bug fixes
    [128x160_Dashboy_Camera.ino]
2023-09-15 Gerber update for tiny adapter board
2023-09-15 Design update for adapter board
    [PCB_Tiny board_2023-09-15.json]
2023-09-28 Minor sensor range tuning
2024-03-02 Update of deprecated command with Arduinojson
2024-05-20 Some example with M64283FP sensor
2024-05-20 showcases with M64283FP sensor
2024-05-21 debagame mode to study camera calibration
2024-05-22 Note about coupling GB camera mode et 83FP sensor
2024-05-22 comments on the auto-calibration circuit of the 83FP
2024-05-23 Sensor auto-calibration (WIP)
    for 82FP only, the 83FP yet performs this automatically
2024-05-23 comment about self calibration added
2024-05-23 comments about the 83FP calibration circuit
2024-05-25 fixed error in comments
    [config.h]
2024-06-04 Prototype for slit scan mode
2024-06-04 Slit scan mode : some minor fix
    [128x160_Dashboy_Camera.ino, config.h]
2024-06-07 Slit scan modes can be accessed from push buttons now
2024-06-24 Prototype for RGB mode
2024-06-25 Adding servo position list
2024-06-25 Code to drive servo via GPIO22
2024-06-25 Init servo @0° in setup
2024-06-26 New build with servo control
2024-06-26 Add files via upload
    Add wiring for servo motor
2024-09-10 Improves servo angle rotating range
2024-09-12 Improves servo control (sweeping)
2024-09-13 Minor bugfix on servo management
    [128x160_Dashboy_Camera.ino, config.h]
2024-09-14 Better servo control
2024-09-27 Fixes a string overflow
    [128x160_Dashboy_Camera.ino, config.h]
2024-11-10 MS split in 1024 images for safety + bugfix
    Suppresses a pointless access to SD card that creates bug when exiting Motion Sensor mode
    [128x160_Dashboy_Camera.ino, config.h]
2026-06-07 Automatic white calibration
